cxy-299/jingjue-xingzhe/fpga/motor_bt_drive/README.md

# 蓝牙四向闭环离地试验（BTD5）

当前 SIN4 集成位流、IMU/ToF GUI 回传、ToF 急停锁停、逐轮 PI 故障定位与减速闭环的构建、仿真及 SRAM 下载记录见 [SIN4 维护记录](../../output/board/SIN4_PI_TOF_DIAGNOSTIC_2026-10-26.md)。[SIN3 维护记录](../../output/board/SIN3_TOF_STOP_INTERLOCK_2026-10-25.md)及下文保留早期阶段性结果，不能替代 SIN4 的实机验收。

本工程仅用于四轮**离地**验证蓝牙前、后、左、右控制，不能直接作为落地行驶或比赛正式位流。实物车头按用户确认的 **M1/M2 端**，M3/M4 为车尾。四路速度 PI 来自已经离地实测的 4CL2；BTD4 增加 S0 复位后的显式停止锁，BTD5 增加蓝牙侧编码器诊断回传。

## 硬件接线门槛

驱动板 12 V 先关闭，FPGA 和蓝牙模块断电后才接线。ZS-040 底板六针丝印（背面排针朝下从左到右）为 `EN、VCC、GND、TXD、RXD、STATE`；底板名称不代表某个确定的供电规格。先确认所持模块允许的 VCC 输入，再给模块单独上电并以模块 GND 为参考实测 TXD 空闲高电平；**确认不超过 3.3 V 后**，才能将 TXD 接 FPGA P7-23/E16。FPGA 与蓝牙模块须共地，5 V 绝不能直接送入 FPGA GPIO。

先下载 [蓝牙隔离回显位流](../bluetooth_bringup/README.md) 验收 9600/8N1、TXD/RXD 与回显；该位流所有电机输出固定为低。2026-10-24 已用 Windows 蓝牙 SPP COM9 发送 `A`、`B`、`A` 并收到完全对应的回显，证明电脑—蓝牙—FPGA 双向串口贯通，**未验证电机遥控**。当前 iPhone 小程序不支持这只经典蓝牙模块，可先使用 Windows。

## 手机蓝牙助手协议

Windows 可使用 [pc_bt_control.py](pc_bt_control.py) 进行离地遥控（`python pc_bt_control.py --port COM9`，需 `pyserial`）。点击连接发送停止 `S` 和标准速度档 `3`；还须手工勾选“允许离地试转”。方向按钮必须按住才会每 100 ms 重发，松开、窗口失焦或关闭时发 `S`。换向先停，必须松开后重新按目标方向。**BTD4 不要求按 FPGA S1**，但仍保留 S0 急停、FPGA 失联看门狗和驱动板电源开关。方向字节持续刷新时，点击锁定可以连续运行；最后一个刷新字节之后约 300 ms 无刷新，FPGA 自动停车。XCOM 不得同时占用 COM9；诊断仍走板载 COM6/115200。

手机按钮按下时每 100 ms 重发一个 ASCII 字符；松开时发一次 `S`。仅发送单个字节、不重复的按钮最多运行约 300 ms。`\r`、`\n` 和其他字符不刷新安全看门狗。

| 按钮 | 发字符 | 轮速方向（+ 表示该轮朝车前进方向） |
|---|---|---|
| 前 | `F` | M1+、M2+、M3+、M4+ |
| 后 | `B` | M1−、M2−、M3−、M4− |
| 左横移 | `L` | M1+、M2−、M3−、M4+ |
| 右横移 | `R` | M1−、M2+、M3+、M4− |
| 停止 | `S` | 全部 PWM、IN1、IN2 为低 |

`L/R` 使用标准麦克纳姆 X 布局组合；底盘滚轮的实际 X/O 安装、左右运动方向尚未落地验证。若实车安装不同，必须根据低速地面测试修正，不能凭离地轮转断言横移正确。

速度档位仅在停车时生效：`1`、`2`、`3` 分别设置闭环目标 **12、16、20 个编码器四倍频计数/10 ms**；运动中收到调速字节会忽略。电脑界面调档先发 `S` 再发档位字节。默认档位为 `3`；这些是计数目标，不是已校准的 m/s。最高档不超过此前四轮离地实测的 20，最低档能否稳定维持仍待实测。板载串口诊断中的 `Txxx` 随档位显示实际目标。

## GUI 死手控制与 FPGA 停机

1. 上电就绪后至少保持 100 ms 中性状态。GUI 的本地“允许离地试转”默认关闭；只有按住方向按钮才每 100 ms 重发 F/B/L/R，松开即发 `S`。FPGA 不依赖 S1。
2. 最后一个合法方向字节之后约 300 ms 无刷新即全停；同方向刷新会清零运行租约计时，不再因固定 3 秒计时器误停。换向仍须先发送 `S` 并等待约 100 ms 中性间隔，再发送新方向。
3. 从运动中直接换向立即停车并锁定；先发送 `S` 再发新方向。S0 急停直接门控全部输出；**S0 松开后仍锁停，持续刷新的旧方向字节无效，必须先收到 `S` 才能重新起动**。串口帧错误、任一编码器无反馈、反向反馈或超速也导致全停。若 GUI 已连接而 FPGA 后复位，先松开方向并点一次“停止 S”。
4. 四轮错峰起动由 BTD2 的每路 125 ms 缩为 **40 ms**（M4 最晚 120 ms），仍有 100 ms 起动脉冲。此前 0.5 秒 BTD2 试验中 M3/M4 几乎不转，最晚启动 375 ms 是重要解释，但尚不能排除机械阻力、供电或 PI 参数因素。PI 占空比限幅 300～850‰；只有离地验证后才能讨论落地调参。

板载 CH340 串口仍以 115200/8N1 轮询发送 `M1 T020 A+020 D0700 F0` 之类诊断帧；BTD5 还从 D16/P7-24 以 9600/8N1 向蓝牙模块回传同类 M1～M4 诊断帧，GUI 可在 COM9 显示最新行。LED2 心跳、LED3 就绪、LED4 任一路输出、LED5 蓝牙/连续运行超时、LED6 四路都曾收到反馈、LED7 安全告警。

## 离线验证与待测项目（2026-10-24）

### 2026-10-25 SIN1 点击锁定修正版

`bt_motion_guard` 对合法同方向刷新执行运行租约续期。统一驾驶台的点击锁定模式每 100 ms 刷新一次，持续刷新时不再触发旧的 3 秒误停；停止刷新约 300 ms 后仍由 FPGA 看门狗停车。新位流为 `output/board/SIN1_btd6_imu_tof_nav_follow_2026-10-25.fs`，User Code `0x53494E31`，SHA-256 `8EEC09957EC9EDD2FD184DC819683083E6EC29D3F582D849579DBED972C243C9`。该位流尚未完成本轮上板验证。

- ModelSim 2020.4 `vsim -c -do run_modelsim.do`：2026-10-24 BTD4 PASS，编译错误 0、警告 0；覆盖直接 GUI 控制 F/B/L/R、速度档、四轮反馈、停车后换向、300 ms 看门狗、S0 急停、串口帧错误和连续运行限时。测试使用缩短后的时序参数，真实硬件时间待实测。
- Gowin V1.9.12.04：GW5AT-LV60PG484AC1/I0，50 MHz 约束，BTD4 构建成功；实际 Fmax **73.696 MHz**，建立/保持违例端点 **0**；逻辑 4290/59904（8%）、寄存器 949/60780（2%），I/O 30/297。User Code `0x42544434`；位流 SHA-256 `CC67ECC88F99878250253F25BC49017DDE7BA7A33B6029F4A09D862D58EF7B04`。BTD3 位流在 `impl/pnr/acg720_motor_bt_drive_BTD3_backup.fs` 备份。
- BTD4 已在驱动板 12 V 关闭、四轮离地条件下下载到 FPGA **SRAM**，CLI 返回 `Finished`、User Code `0x42544434`、Status Code `0x70026020`；随后已用 Arora V 操作 54 完成外部 Flash 擦除/写入/校验，工具返回 `Program and Verify Flash successfully`，操作 66 独立复核返回 `Verify Flash successfully`。断电上电后的启动镜像仍需用户在安全状态下复核；未完成落地运动验证。
- 离地前进实测：无需 S1，GUI 按住 `F` 后四轮同向，松开后全停，LED7 灭。连续三组运行中诊断为 `A+024/+018/+016/+015`、`A+012/+016/+017/+018`、最终 `A+020/+020/+020/+021`，均为 `T020`；最终占空比 `D0702/D0716/D0710/D0713`，四轮稳态误差分别为 **0/0/0/+1 计数/10 ms**。这支持“离地稳态速度一致”的结论，但不能推断载荷下地面速度、位移或横移精度。
- 离地后退实测：GUI 按住 `B`，四轮最下缘均朝车头，松开后全停且无安全告警。运行帧 `M1～M4` 曾为 `A+013/+015/+016/+017`、`D0642/D0686/D0679/D0697`；稍后 M1～M3 均到 `A+020`，M4 同组 `D0000` 是松开时序附近的采样，不应解释为闭环驱动中占空比为零。后退轮向通过，四轮同时稳态收敛仍需更完整连续帧。
- 离地左横移轮向实测：`L` 时 M1/M4 最下缘朝车尾、M2/M3 朝车头，与 RTL 对角配对一致，松开全停、无告警。运行帧曾为 `A+028/+023/+022/+017`、`D0412/D0436/D0384/D0459`；下一组为 `A+011/+016/+014/+018`、`D0611/D0692/D0661/D0715`。仍属短时过渡采样，不能当成横移位移或稳态精度证明。

- 离地右横移轮向实测：`R` 时 M1/M4 最下缘朝车头、M2/M3 朝车尾，松开全停、无告警。连续三组 `T020` 下，四路 `A` 均为 `+020`；对应占空比约 `D0692～D0719`。这是轮速一致性与轮向验证，**不是落地横移位移验证**。
- BTD4 修复：复位及上电时 `require_stop=1`，防止 GUI 持续刷新 F/B/L/R 时 S0 松开即自行恢复运动。ModelSim 回归 PASS（编译错误/警告均 0），新增“复位后旧方向持续发送仍停机，收到 `S` 后才可重新启动”的检查。Gowin 50 MHz 时序下实际 Fmax **73.696 MHz**，建立/保持违例端点均 **0**；逻辑 4290/59904、寄存器 949/60780、I/O 30/297，User Code `0x42544434`，位流 SHA-256 `CC67ECC88F99878250253F25BC49017DDE7BA7A33B6029F4A09D862D58EF7B04`。驱动板 12 V 关闭时已下载到 SRAM，返回 `Finished`、Status `0x70026020`；上板 S0 锁停与 Flash 固化尚待验收。
- Windows GUI 优化版为 `pc_bt_control_btd4.py`：可扫描/选择 COM9、显示打开与发送故障状态、累计 TX 字节、最近发送时间及事件日志；写入超时或部分写入会立即断开并撤销试转许可。它明确标注“无 FPGA ACK”，因此不能把“COM 已打开”误当作 FPGA 已收到。

## 分阶段实测记录

## BTD5 固化记录（2026-10-24）

- BTD5 位流增加独立蓝牙 TX 诊断通道，用户码 `0x42544435`；ModelSim 回归通过，Gowin 实际 Fmax 63.187 MHz，建立/保持违例端点均为 0，位流 SHA-256 为 `E292132B9363492BCEEF198E7BA65C3929F3D40B9E18930D43A1070A3C8DF210`。
- BTD5 已在四轮离地、驱动板 12 V 关闭条件下下载 SRAM，随后通过 Gowin Programmer 操作 54 写入外部 Flash；操作 66 独立校验返回 `Verify Flash successfully.`。用户码、Flash ID `0xC22018` 和校验日志保存在 `impl/pnr/btd5_flash_verify_20261024.log`。
- 维护复现步骤、完整命令、接线、电气门槛、GUI 操作、回滚和未完成实测项目见同目录 [BTD5维护与复现手册.md](BTD5维护与复现手册.md)。

| 阶段 | 通过条件 | 当前状态 |
|---|---|---|
| 模块电气 | VCC 规格确认、TXD 空闲高电平 ≤3.3 V、共地 | 待测 |
| 隔离回显 | 12 V 关闭，Windows COM9 发送 `A/B/A` 并收到对应回显，电机输出恒低 | 已通过（2026-10-24） |
| 离地遥控前进 | `F` 同向、松开停、T020 下四路速度收敛、LED7 灭 | 已通过初步实测（2026-10-24） |
| 离地遥控后退 | `B` 四轮最下缘朝车头、松开停、无告警 | 已通过初步实测（2026-10-24） |
| 离地左横移轮向 | `L` 对角轮向组合、松开停、无告警 | 已通过初步实测（2026-10-24） |
| 右横移轮向 | `R` 对角轮向组合、松开停、T020 四轮收敛 | 已通过离地初步实测（2026-10-24） |
| 安全保护 | BTD4 S0 锁停、断连、3 秒限时的实物效果 | S0/取消试转后输出熄灭已观察；LED7 告警原因需继续记录；ModelSim 已通过 |
| 低速落地 | 另行制定低速限时位流与现场安全边界 | 禁止直接开展 |
