cxy-299/jingjue-xingzhe/fpga/motor_encoder_direction/README.md

# M1 电机—编码器方向联调（EMD1）

本工程用于确定 M1 在既定 `IN1=1、IN2=0` 驱动方向下，编码器四倍频计数的符号。它是**单轮开环限时诊断位流，不是 PID 闭环**；其余 M2～M4 的 PWM、IN1、IN2 输出均保持低。M1 对应车上的 B 轮（左后），编码器 AM1/BM1 必须先经 TXS0108E 由 5 V 转为 3.3 V，接到 FPGA P7-15/16（D14/D15），禁止直连 5 V。

## 电机输出与指示

- S0：立即停止并清除编码器结果；S1：单击启动、再单击停止。一次启动最长 700 ms，到时自动停机。
- M1 启动时先 100 ms 全占空比起动，随后 80% 占空比，载波目标 20 kHz；M1 的 IN2 始终为低。
- LED2：心跳；LED3：启动互锁完成；LED4：M1 正在运行；LED5：本次运行达到 700 ms 自动超时；LED6：本次**电机主动驱动期间**至少收到一次 M1 编码器计数变化；LED7：最后一次计数变化为负数。LED6/7 只在下一次启动或 S0 复位时清除。
- LED6 未亮时，不能依据 LED7 判断方向；LED7 只反映最后一次脉冲的方向，不能代表全程没有反向毛刺。

## 安全上板顺序

1. 四轮离地，驱动板 12 V 关闭，S1 松开。确认 FPGA 与驱动板共地、TXS0108E A/B 两侧供电及 OE 使能正确。
2. 仅以 Gowin Programmer 的 **SRAM Program** 下载 `impl/pnr/acg720_motor_encoder_direction.fs`，确认 `Finished`、User Code `0x454D4431`（EMD1）。不得写入 Flash。
3. 保持 12 V 关闭，确认 LED2 闪烁、LED3 常亮、LED4～7 全灭。若不符，不要开启 12 V。
4. 开启 12 V 后先观察是否有意外转动、发热或异味。确认安全后单击 S1 一次，观察是否只有 M1 转动、实际车轮下缘运动方向，以及运行结束后 LED5/6/7 状态；任何异常立即关闭 12 V 或按 S0。
5. 记录电机驱动方向与编码器符号后，关闭 12 V。本工程不能验证 PID 调参、四轮速度一致性、导航或带载表现。

## 离线与下载记录

- ModelSim：`PASS tb_acg720_motor_encoder_direction: one motor, quadrature sign, timeout, reset`，0 errors、0 warnings。
- Gowin V1.9.12.04：50 MHz 约束，Actual Fmax 88.574 MHz，建立/保持违例终点均为 0。
- SHA-256：`EC23F8245BFC12994D72D247DF6162993F515B62441F45B4769636723D2BDF4C`。
- 2026-10-23：在用户确认驱动板 12 V 关闭、四轮离地后，仅下载到 FPGA SRAM。Gowin CLI 回报 `Finished`、User Code `0x454D4431`、Status Code `0x70026020`。

## 2026-10-23 M1 上板结果

- 用户确认 12 V 关闭时 LED2 闪烁、LED3 常亮、LED4～7 全灭。开启 12 V 而未按 S1 时，四轮静止，无异味、明显发热或电源异常。
- 单击 S1 后只有 M1（B 轮、左后）转动，其轮子下缘朝车尾运动，约 700 ms 后自行停止。停后 LED5、LED6、LED7 全亮。
- 由 LED5 确认硬超时动作；LED6 确认主动驱动期间 M1 编码器确有计数；LED7 说明最后一次计数变化为负。这与先前按车辆前进方向手转 M1 观测到负计数一致。
- 用户随后确认关闭驱动板 12 V。当前只确认 M1 的**方向极性及低速反馈存在**；尚无每 10 ms 的实测计数、编码器每圈计数或速度环调参数据，不能宣称闭环已通过。
