cxy-299/jingjue-xingzhe/fpga/COMPETITION_INTEGRATION_2026_CN.md

# 赛题三最终整合与高分验收路线（2026-10-24）

目标板：ACG720 / GW5AT-60B。场地草案：2 m × 2 m、20 × 20 格；车头为 M1/M2 端。IMU 实物明天到，今天不假定型号、协议或角度方向。本文是实施与验收计划，**不是整车已经通过的声明**。

比赛依据：[高云 2026 官方选题三](https://www.gowinsemi.com.cn/university/match2026)。官网明确列出基础任务 1～4 和扩展任务 5～6；作品提交时间写为 **2026-11-04 18:00**，决赛为 11 月 20～22 日。用户截图中的 40%/25%/20%/10%/5% 分布作为备赛优先级参考，官网当前网页未给出同一评分权重，不能把它写成官方量化规则。基础任务采用 FPGA/板上软核独立完成的设计路径；树莓派负责扩展视觉、交互、日志，不替代 FPGA 安全控制与导航执行。树莓派 4B 是否满足扩展平台细则，以比赛补充规则或组委会答复为准。

## 1. 当前真实性能基线

| 任务 | 已有可复核证据 | 整合版仍缺 |
|---|---|---|
| T1 摄像头 + IMU + 同屏显示 | OV5640 厂家 HDMI 独立 SRAM 位流，用户现场确认实时画面正常；IMU UART 解析仿真 | IMU 实物协议/角度验证，HDMI 姿态角 OSD，同一位流运行 |
| T2 前后/转向/定点旋转 + 编码器闭环 | BTD5 四轮离地 F/B/L/R 闭环、松手停；写入 Flash 并校验 | `L/R` 当前是横移，**不是定点旋转**；转弯/原地旋转指令与载地实测仍缺 |
| T3 测距/减速/停车/自主绕障 | 一只 MS53L2M 原始距离 455～467 mm、分档 LED 现场通过 | 安全链未接电机；没有实物减速/制动/绕障；仅一只前向 ToF 不能提供四周覆盖 |
| T4 起终点/避障/路径点导航 | BTD6 完整路径帧、CRC、编码器逐格执行已仿真并离地验证；GUI 地图 v4-balanced 保留原版四个障碍位置并各缩短约 2 格；1/2/3/34 步目标均完成；转向路点之间加入中性停车 | 当前仍以固定起点和 GUI 路径为主；ToF 动态障碍已完成软件安全/重规划仿真，尚未接入 BTD6 顶层和实车回执 |
| T5/T6 扩展 | Pi 侧瓶子识别与网页画面曾实测 | 红瓶筛选抗干扰、目标定位、搜索→接近→停止全任务未实车验证 |

**结论：单模块测试已为整合降低风险，但 T1～T4 尚不能宣称整题完成。**既有 BTD5 Flash 是回退基线，不在整合版本通过全套验证前覆盖。

## 2. 最终单一系统的数据和控制边界

```text
OV5640 ─ SCCB/DVP ─ DDR3 ─ 显示时序 ─ 字模OSD ─ HDMI
IMU ─ 校验/角度/时效 ───────┘       └─ 航向估计
ToF(前，未来多方向) ─ 距离/时效 ─ 安全与局部障碍层 ─┐
编码器 M1～M4 ─ 速度/里程计 ─ 位姿估计 ─ 路点跟踪 ─┼─ 唯一运动仲裁 ─ 四路 PI/PWM ─ 驱动板
已知地图 + 当前位姿 + GUI 目标 ─ FPGA BFS/重规划 ─┘
蓝牙手动/树莓派视觉目标 ─ 模式请求与低带宽遥测（不得直接写 PWM）
``` 

- **唯一电机所有者：FPGA。** 蓝牙、GUI、导航、红瓶任务只能提交有时效的运动意图；控制仲裁每周期只选一个来源。S0 急停 > ToF 近距或必需传感器失联 > 编码器/驱动故障 > 通信超时 > 当前模式命令。故障后要求中位命令和人工重新使能，不允许旧命令自动续跑。
- **执行器基线沿用 BTD5。** 它是当前真实驱动板上离地验收过的四路 PI/PWM 和编码器符号；旧版 `fpga_robot_core.v` 或 NAV3 预览顶层不能未经硬件重验就替换该执行器。先把 BTD5 的命令来源抽象为模式仲裁输入，再接导航和 ToF，不同时维护两套轮序/电机极性。
- **单一时间/坐标定义：** 地图原点左下、`x` 向右、`y` 向上；车体前向为 M1/M2 一端。IMU 的 yaw 零点、正方向需实物标定。地图坐标与车体前/右速度经过航向变换后才送麦轮混控。地图版本、GUI 预览、FPGA ROM 和实体障碍布局必须同源生成。
- **角度显示：** 在 HDMI 像素输出至编码器之前叠加 roll/pitch/yaw、距离、模式和故障字样；多位姿态数据跨时钟域握手后在帧边界更新，超时显示 `IMU LOST`。Pi 网页可镜像遥测，但不能是基础任务唯一显示。
- **蓝牙与 ToF 管脚：** ToF 诊断曾临时复用蓝牙 RX 所在 E16/P7-23；整合版须逐根重新分配，不能让两个 TXD 并接。合并相机/HDMI/DDR3/电机/编码器/IMU/ToF 约束后再跑 IO 冲突与时序检查。
- **安全距离：** 现有 800/500/250 mm 仅是代码初值，不是地面安全证明。需实测最坏控制/测距延迟和最大减速度，按 `停止距离 ≥ 速度×延迟 + 速度²/(2×减速度) + 车体余量` 设动态阈值；失联时前进停车。

## 3. 优先级与交付门槛

### A. 先保证基础任务可得分，再做扩展

1. **T2 补全动作。** 在 BTD5 的四路速度闭环之上添加转弯和原地左/右旋转，不把横移充当旋转。先仿真四轮符号、停车换向和编码器失效，再离地、最后空旷地低速落地测角度/直线误差。
2. **T3 接入安全链。** 单只前向 ToF 可先完成“前进发现→自动减速→自动停”实车证据；自主绕障须在停稳、已知车体扫掠空间安全、局部占据更新后重新规划。单只前向传感器无法给侧移和盲区旋转提供全周安全保证；若要现场稳定演示绕障，优先补多方向 ToF，而不是提高 PWM。任何无路、未知空间或传感器失效都停车。
3. **T1 合成 HDMI+IMU。** IMU 到货后先核对真实波特率/帧格式/电平与方向，再叠加姿态角；独立摄像头画面和传感器数值要在同一位流、同一显示器上同时工作。
4. **T4 实际导航闭环。** 从当前实测位姿而非固定 `(18,1)` 起算；`BFS 路点→低速跟踪→编码器+IMU位姿→到点脉冲 advance_i→下一路点`。ToF 发现新障碍时停稳、更新局部占据、从当前位姿重规划；到终点需位置/航向/低速持续满足再回报 `ARRIVED`，不能仅凭浏览器蓝线或 FPGA `ready` 灯。
5. **T5/T6 最后扩展。** FPGA 基础任务已稳定后，Pi 做红瓶检测，发目标类别/置信度/方位及时间戳；FPGA 负责搜索、对准、接近和安全终止。勿让红瓶推理卡顿维持陈旧运动命令。

### B. 设计门禁（每一版都要过）

| 门禁 | 通过标准 | 证据 |
|---|---|---|
| 静态 | 无重复 IO、无电压超限、时钟/复位/跨时钟域审查通过 | 管脚矩阵、约束差异、CDC 清单 |
| 仿真 | 正常、边界、失联、错误帧、复位、故障抢占均有断言 | ModelSim 日志与原始波形 |
| 实现 | Gowin 综合/PnR 成功，建立/保持违例为 0，资源有余量 | `.rpt.txt`、User Code、位流 SHA-256 |
| 无动力上板 | 12 V 关闭，视频/IMU/ToF/蓝牙/导航回执同版通过 | 现场录像、遥测日志 |
| 离地动力 | 四轮方向与闭环正确，近障/失联立即禁止 PWM，松手停 | 连续测速与故障注入记录 |
| 落地 | 空旷场低速开始；重复试验不碰撞，测制动、到点和回退 | 卷尺/轨迹/视频/试验表 |

评委演示时应能在 HDMI 上看到摄像头、姿态、距离、当前模式与停机原因；在 GUI 上看到地图、**FPGA 回执**、当前估计位姿、规划/执行/到达状态及四轮目标/实测速度。网页“发送成功”只表示 Pi 写串口，绝不能显示为“FPGA 已到达”。

统一电脑驾驶台的现有安全首版与最终 COM9 协议门槛，见 `motor_bt_drive/统一驾驶台_维护与整合说明.md`。当前仅同窗提供 BTD5 离地遥控、编码器回传、地图预览；NAV/任务按钮在新 FPGA 位流与 ACK 完成前锁定。

## 4. 地图与机械几何必须先校正

当前 GUI 地图 v4-balanced 是 10 cm/格、原版四个障碍位置的缩短版；A 为 `(11,4)` 的 2×3 格，B 为 `(6,9)` 的 2×2 格，C 为 `(13,13)` 的 2×2 格，D 为 `(4,15)` 的 1×2 格。车辆约 20 cm 宽，却采用 15 cm 膨胀半径，起点中心仅距边界 15 cm。若含麦轮、线材的实际长宽约 20×20 cm，原地旋转包络半径约 14.1 cm，加 5 cm 裕量约 19.1 cm；现起点与膨胀设置不能直接保证安全。落地前量出车体最大外廓、轮距和转弯扫掠，将地图、PDF、网页、FPGA ROM 同时升级版本；**不静默沿用地图 ID `0x2601`**。四轮目标 `T020` 是编码器计数/10 ms，不是 m/s；要实测轮径、每转计数、地面滑移才可换算位移。

## 5. 提交前的时间优先级与回退

按官网 11 月 4 日 18:00 提交节点，先冻结一版可复现实演的基础系统，再加风险较高的任务。建议顺序：

| 阶段 | 主要交付 | 失败时保底 |
|---|---|---|
| IMU 到货当天 | 原始帧/方向验证，HDMI 姿态 OSD 仿真与 SRAM 同屏 | 保留独立 HDMI 画面和可复核 IMU 原始采集，不伪称同屏 |
| 随后 | T2 原地旋转、T3 单向减速停车，离地→落地低速验收 | BTD5 Flash 可随时恢复四轮遥控基线 |
| 基础稳定后 | 位姿估计、当前起点 BFS、路点跟踪、目标回执，2×2 m 多目标重复跑 | 展示 FPGA 路径规划和部分路点闭环，明确未完成的整车能力 |
| 最后 | 动态绕障、红瓶识别/搜索接近、答辩视频与证据包 | 绝不牺牲基础稳定性换未经验证的 AI 展示 |

内部建议验收量化（**非官方门槛**）：每个运动/避障/导航场景至少 5 次重复；0 次碰撞；保存每次起终点误差、最大姿态误差、最近障碍距离、故障状态和完整版本号；让失联/急停/重启测试可由评委现场复现。最终报告逐项区分“仿真通过”“离地通过”“落地通过”“未通过”，不以演示视频替代原始数据。

## 6. 评委可直接看见、又确有技术内容的亮点

1. **一屏可解释的 FPGA 实时链路：** HDMI 同时显示现场摄像头、姿态角、前方距离、四轮闭环状态、导航模式和停车原因；断开 Pi 后基础功能继续运行，以实物展示 FPGA 主控职责。
2. **可量化的确定性安全：** 用逻辑分析/串口时间戳与录像测量“测距帧到达→降速/禁 PWM”的最坏时延，再结合地面制动实验给出速度相关安全距离；使用预先设计的断线测试开关或在断电状态下配置故障场景，验证失联停车，不带电拔插传感器。
3. **真正闭环而非动画：** 让网页的规划路线、FPGA 回传的路点编号、编码器/IMU 位姿和实车轨迹同时可见；故意放置未在固定图中的障碍，展示停稳、重规划与继续执行。若当时未实现，不在报告中写成已完成。
4. **严格可复现：** 每次演示保存地图 ID、位流 SHA-256/User Code、管脚表、ModelSim 日志、时序余量、原始串口数据、至少 5 次重复试验统计以及失败案例。创新点必须附可观测证据，不只写算法名。
