cxy-299/jingjue-xingzhe/fpga/CONTROL_AUDIT_2026-10-14_CN.md

# FPGA 控制逻辑核查与赛题三差距（2026-10-14）

本次只做源码检查与软件仿真；没有重启电脑、连接电机、下载 FPGA 或改变板卡固件。

## 仿真证据与边界

在独立目录 `verify_motion_20261014` 中，ModelSim SE-64 2020.4 的 `vlog` 已将 10 个 RTL 和 4 个 testbench 编译为 **0 errors / 0 warnings**。本次终端启动 `vsim -c` 返回 `Invalid license environment`；尝试打开已安装的 ModelSim GUI 也没有产生可操作窗口。因此不能声称本次 ModelSim 仿真通过；用户先前在 GUI 手动执行的三项 PASS 日志与本次 XSIM 结果相符。许可证/GUI 恢复后，可按 `MOTION_MODELSIM_MANUAL_CN.md` 重新在 GUI 跑四项。

同一源码用 Vivado XSIM 2019.2 独立完成：

| 自检顶层 | 结果 | 覆盖要点 |
| --- | --- | --- |
| `tb_motion_policy` | PASS，230 ns | 安全优先级、无目标搜索、确认、跟随、死区 |
| `tb_wheel_control` | PASS，2531 ns | 麦轮混控、编码器正反计数、PI 禁用、PWM |
| `tb_four_wheel_pid` | PASS，1151 ns | 四路独立占空比、D 项、防积分饱和、停车 |
| `tb_drive_rearm_guard` | PASS，111 ns | 立即关断、等待控制周期恢复、短故障脉冲锁存 |

以上证明已覆盖的**逻辑片段**自洽，不证明完整系统已经可在 ACG720 上跑。特别是四路 PWM 自检使用仿真缩短的载波周期，并没有验证真实 20 kHz 输出的管脚波形、电平、电流或方向极性。

## 本次逻辑优化

之前急停或 ToF 故障解除时，旧的占空比有机会在下一个控制时钟清空前短暂重新出现。增加 `drive_rearm_guard.v` 后，任何故障立即组合关断 `motor_enable/PWM`，同时异步锁存；故障解除后必须等下一控制周期才放行。测试还覆盖短于时钟周期的故障脉冲。板级仍需确认驱动器的使能极性、硬件急停与故障输入是否真正连入。

## 对照赛题三的完成状态

根据 `E:\gowin\高云.pdf` 第 17–18 页，基础任务包括相机采集/显示和 IMU 姿态显示、编码器闭环运动、传感器避障并自动绕行、起终点及途经点自主导航；扩展任务才是视觉目标搜索与语义任务。当前状态：

| 要求 | 当前代码 | 结论 |
| --- | --- | --- |
| FPGA 实时运动控制、四轮编码器速度闭环 | 麦轮、四路编码器、PI/PID、PWM 已有独立仿真 | 逻辑雏形已具备；板级未集成/标定 |
| 树莓派视觉信息到 FPGA | UART 解析、CRC、心跳及超时已有测试 | 通信逻辑具备；完整系统联调待做 |
| 摄像头采集/图像及 IMU 姿态实时显示 | 目前无 FPGA 相机采集/显示和 IMU 模块 | 未完成 |
| ToF/超声/雷达减速、停车、绕障 | 单一前向 ToF 距离策略仅会减速/停车/视觉跟随 | 绕障未完成；传感器适配器未完成 |
| 起点到终点、途经点自主导航 | 无定位融合、地图/路径/途经点模块 | 未完成 |
| 红水瓶识别/定位/搜索 | 视觉包有目标字段，策略可原地搜索/对位/接近 | 红瓶识别、坐标定位和目标任务闭环未完成 |

因此当前方案**符合“FPGA 应承担运动控制核心”的方向，但尚不满足赛题三整题交付**。现有 `vision_motion_controller.v` 是目标跟随策略，不应命名或展示为完整自主导航。树莓派可做 YOLO 感知，但不应把路径、避障和轮控决策全部放在树莓派上。

## 上板前的硬性条件

1. 明确 ACG720 时钟、电平、UART、四路编码器、PWM/方向/使能及驱动故障引脚，制作板级顶层和约束；核对新驱动板实际接口。
2. 标定实际电机编码器方向、每控制周期的计数范围、轮序和机械方向。`WHEEL_COUNTS_AT_FULL_SCALE` 当前默认 0，故意锁住电机输出。
3. 完成至少前向 ToF 的真实数据接收、超时和无效值处理；绕障需多方向测距或可观测的替代传感信息。
4. 增加完整核心集成 testbench：真实 UART 帧进入、ToF 状态变化、四轮参考/测速/PWM、失联/急停/复位均须断言。之后再做离地低速联调。
5. 导航另建 FPGA 侧位姿/路标、地图或航点、路径状态机和避障状态机；IMU 数据采集及显示依赛题要求补齐。

蓝牙功能只做预留设计，详见 `BLUETOOTH_CONTROL_PLAN_CN.md`。当前 `wheel_pi.v` 增益是综合时常量，**手机不能在线调 PID**；不能将待开发功能算作已验证。
