cxy-299/jingjue-xingzhe/fpga/motor_bt_drive/BTD6导航下发与复现手册.md

# BTD6 FPGA 自主导航下发与复现手册

## 1. 目标与边界

BTD5 是已经完成实测的蓝牙四轮闭环手动固件；BTD6 在其基础上增加一条
“完整路径帧 → FPGA CRC/地图校验 → 编码器路点执行”的链路。电脑或树莓派负责
在同一张 20×20 地图上规划路径并发送方向序列，FPGA 只接受经过 CRC、地图 ID、
长度和方向码校验的完整路径，不接收 PWM 或轮速命令；四轮 PI、ToF 急停和 S0
安全停机仍由 FPGA 负责。

BTD5 与 BTD6 使用同一个蓝牙 9600/8N1 物理链路，但 BTD5 的导航入口保持关闭。
统一驾驶台默认选择 BTD5，只有选择 BTD6、核对位流并勾选“允许自主导航”后，
“发送终点到 FPGA”按钮才会开放。

## 2. 导航帧

沿用工程已有的协议 v3：

BTD6 使用路径消息 `type=21`。payload 为地图 ID、终点坐标、步数和每步方向：

```text
AA 55 | version=03 | type=21 | seq(u16 LE) | len=(5+n) |
map_id=2601(u16 LE) | goal_x | goal_y | n | dir[0..n-1] |
crc16-ccitt(u16 LE)
```

例如终点 `(2,17)`、序号 1 的 14 字节帧为：

```text
AA 55 03 21 01 00 07 00 01 26 02 11 02 02 00 84 C2
```

方向码固定为 `0=F、1=B、2=L、3=R`。FPGA 只有在 CRC、版本、消息类型、长度、
地图 ID、坐标范围和方向码全部正确时才替换当前路线；坏帧不会改变当前路线。
当前 GUI 地图为 v4-balanced（原版四个障碍位置的缩短版）。FPGA 接收的是完整路径，不保存 GUI
静态障碍表，因此修改地图后不需要改变执行器逻辑，但必须重新确认地图膨胀与实体
场地一致。

## 3. FPGA 执行逻辑

`acg720_motor_bt_nav` 使用 `NAV_ENABLE=1` 打开导航入口：

1. `uart_rx` 以 9600 baud 接收蓝牙字节。
2. `nav_path_parser` 验证 v3/CRC、地图 ID、长度和方向码并产生一个路径脉冲。
3. `nav_route_executor` 按收到的 F/B/L/R 序列逐格执行，并以四路编码器位置的
   平均绝对增量达到 `NAV_CELL_COUNTS` 判断走完一个 10 cm 单元格。
4. 每次只消费一个方向码；方向改变时先插入约 100 ms 中性停车，再开始下一格；抵达终点后自动输出 STOP。
5. 手动命令与导航互斥；S0、编码器故障、蓝牙看门狗和导航异常均优先停车。

`NAV_CELL_COUNTS` 是必须通过实车标定的参数，当前暂设 1000。落地前应在直线
标定段测量 10 cm 的平均编码器增量，再重新综合；不能直接把仿真值当成实际距离。

## 4. 动态障碍处理边界

当前 BTD6 已具备固定路径的编码器执行，但尚未把 ToF 输入接入该顶层。正式动态
绕障流程必须是：

1. ToF 连续有效时按距离阈值分级减速；进入硬停止距离立即禁止 PWM。
2. 停稳后锁存当前执行格和剩余路径，不能继续盲走。
3. 将 ToF 命中的前方格按车体外廓膨胀写入局部占据图。
4. 由 GUI/Pi 或 FPGA 重新规划“当前格→终点”的完整路径，再经 `type=21` 帧发送。
5. 只有收到合法新路径并重新使能后才继续运行；ToF 无效、无路或侧向不可观测时保持停车。

单个前向 ToF 只能可靠完成前方减速/停车，不能独立证明侧向绕障安全。要做可复现
的自动绕障，应增加左右/后向测距，或在停稳后由摄像头/人工确认局部地图，再重新规划。

## 5. 仿真

在 `fpga/motor_bt_drive` 目录执行：

```text
vlog -work sim_btd6_nav_check ..\nav\nav_path_parser.v ..\nav\nav_route_executor.v acg720_motor_bt_drive.v acg720_motor_bt_nav.v tb_acg720_motor_bt_nav.sv
vsim -c -voptargs=+acc sim_btd6_nav_check.tb_acg720_motor_bt_nav -do "run -all; quit -f"
```

必须看到：

```text
PASS tb_acg720_motor_bt_nav: Bluetooth route -> FPGA encoder waypoint
```

该回归覆盖合法路径帧、CRC/地图校验、方向序列加载、首个方向和编码器增量消费；
不代表落地实车已完成，需要另做离地和低速落地验收。

## 6. 综合与下板

先运行 `build_btd6_nav.tcl` 生成 BTD6 位流，用户码为 `0x42544436`。第一次只
使用 SRAM Program，不写 Flash：四轮离地、驱动板 12 V 关闭、JTAG 接好后再下载。
上电初态应为 LED2 心跳、LED3 就绪、LED4～LED7 熄灭。确认编码器回传后再打开
12 V；第一次只做离地单格导航，第二次才做 10 cm 低速落地测试。

标定与正式落地顺序：

1. GUI 选 BTD6、核对地图和障碍膨胀，勾选“允许自主导航”。
2. 选择距离起点 1 格的可达终点，发送后观察四轮是否同向、是否在一个格后停稳。
3. 用尺测量实际位移，按 `NAV_CELL_COUNTS = 编码器增量/0.1 m` 更新参数。
4. 逐步测试 2 格、转角、障碍绕行和 ToF 自动减速/停车。
5. 任意异常先点“停止导航 S”，再关闭驱动板 12 V；不要边带电边改线或切换位流。

## 7. 当前未宣称项目

BTD6 首版仍假设车辆从固定起点 `(18,1)` 开始，尚未接入 IMU 姿态融合、ToF
动态重规划、摄像头目标任务和 FPGA→GUI 的二进制 ACK。GUI 的“已写入”只表示
Windows 串口写入成功；只有后续收到 FPGA 状态帧或完成实车验收，才能在比赛报告
中写成“任务完成”。
