cxy-299/jingjue-xingzhe/THIRD_PARTY_NOTICES.md

# 第三方组件与资料

本工程保留源文件原有的版权、作者和许可标识。仓库未为全部文件统一授予新的开源许可证。

- 高云器件原语、PLL及相机/HDMI参考代码沿用原厂或开发板资料中的授权条件。Gowin与Questa/ModelSim安装程序、完整厂商仿真库不在仓库内。
- 可选YOLO后端依赖Ultralytics及其模型。使用、修改或分发相关代码与权重时，应遵守其原始许可证及模型使用条件。当前数字靶标识别默认使用项目的模板识别通路。
- Python、NumPy、OpenCV、PyYAML、pyserial、Picamera2、pytest以及微信开发者工具分别遵循其自身许可证或服务条款。
- `data/`为工程原有实验图像、标注与数据记录，保留原有用途与来源；硬件设计文件与图片作为本项目的配套资料保存。

依赖通过各自的官方发行方式安装，仓库中的说明不替代第三方许可文本。
