cxy-299/jingjue-xingzhe/data/field_bottle/raw/20261030T112852182968Z/00021.jpg

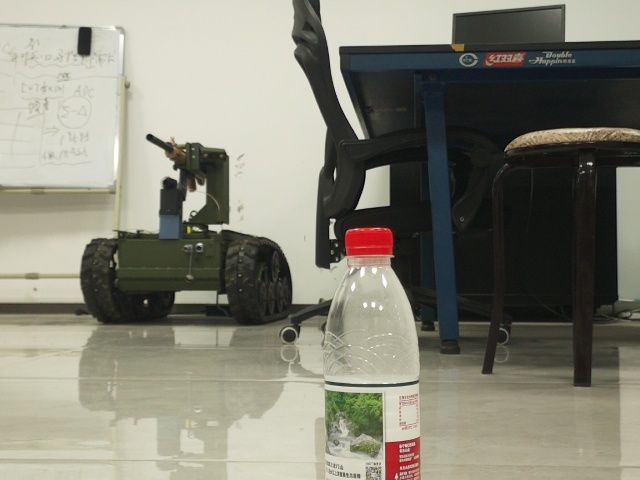
data/field_bottle/raw/20261030T112852182968Z/00021.jpg
