cxy-299/jingjue-xingzhe/data/field_bottle/raw/20261030T114926963797Z/00014.jpg

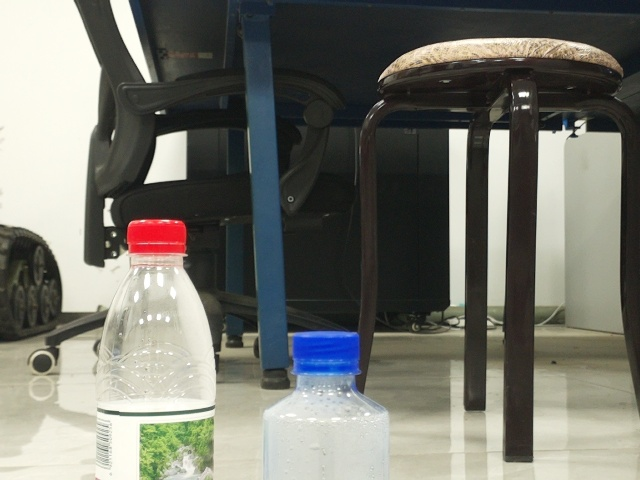
data/field_bottle/raw/20261030T114926963797Z/00014.jpg
