cxy-299/jingjue-xingzhe/data/field_bottle/raw/20261030T121004313350Z/00028.jpg

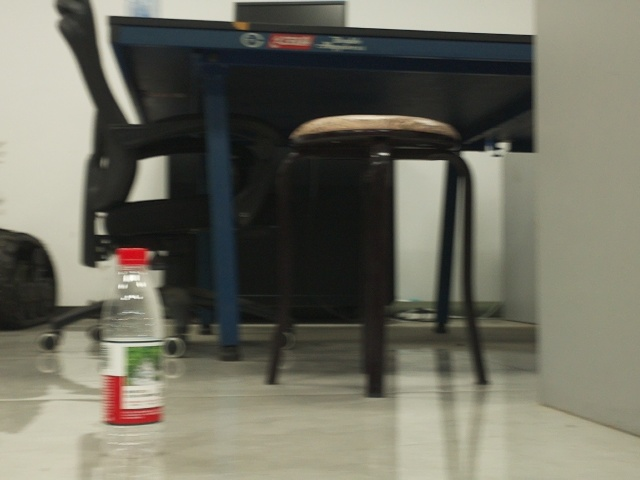
data/field_bottle/raw/20261030T121004313350Z/00028.jpg
