cxy-299/jingjue-xingzhe/data/field_bottle/raw/20261030T121153141556Z/00029.jpg

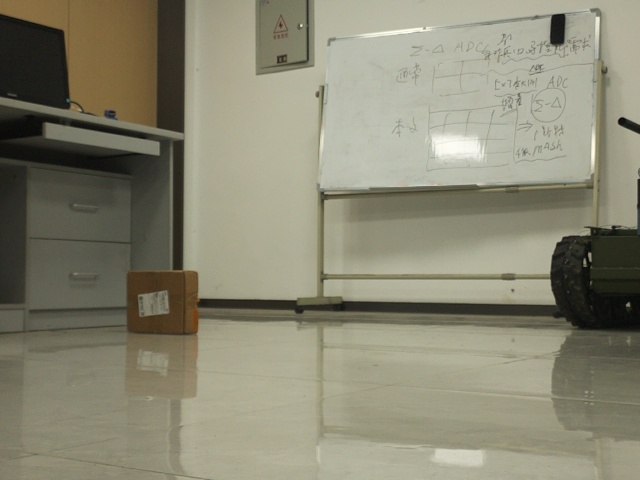
data/field_bottle/raw/20261030T121153141556Z/00029.jpg
