cxy-299/jingjue-xingzhe/data/field_bottle/raw/20261030T122827797892Z/00018.jpg

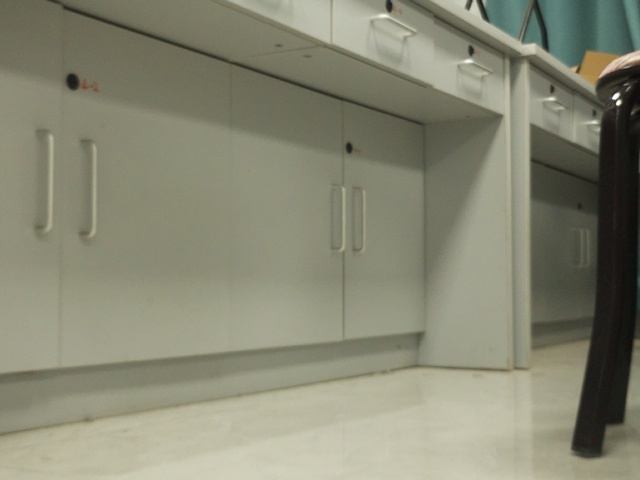
data/field_bottle/raw/20261030T122827797892Z/00018.jpg
