cxy-299/jingjue-xingzhe/data/field_bottle/raw/20261030T123711025227Z/00011.jpg

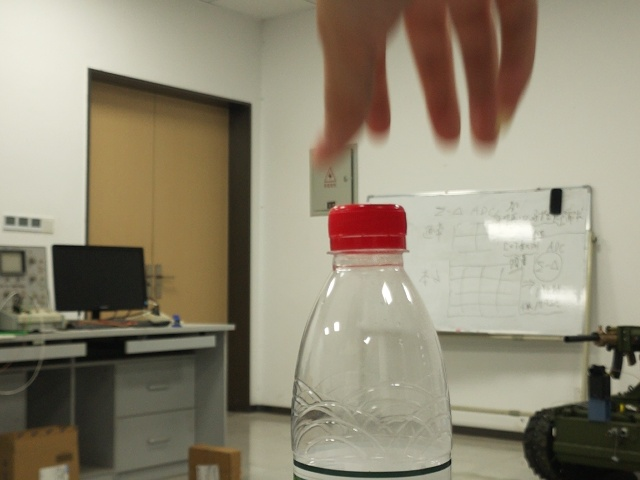
data/field_bottle/raw/20261030T123711025227Z/00011.jpg
