cxy-299/jingjue-xingzhe/data/field_bottle/raw/20261030T123711025227Z/00013.jpg

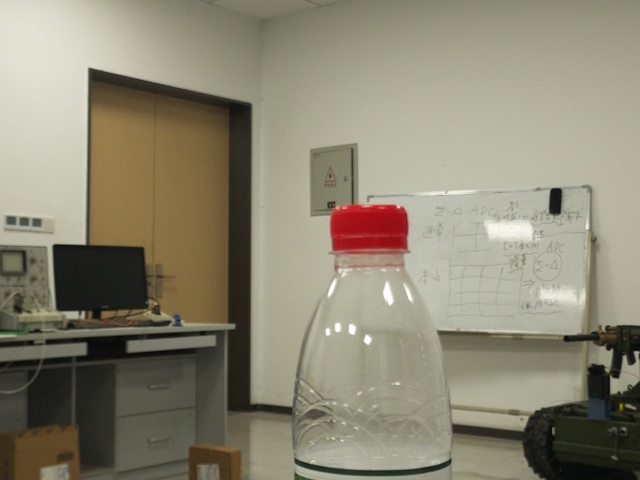
data/field_bottle/raw/20261030T123711025227Z/00013.jpg
