cxy-299/jingjue-xingzhe/data/field_bottle/raw/20261030T124541207972Z/00016.jpg

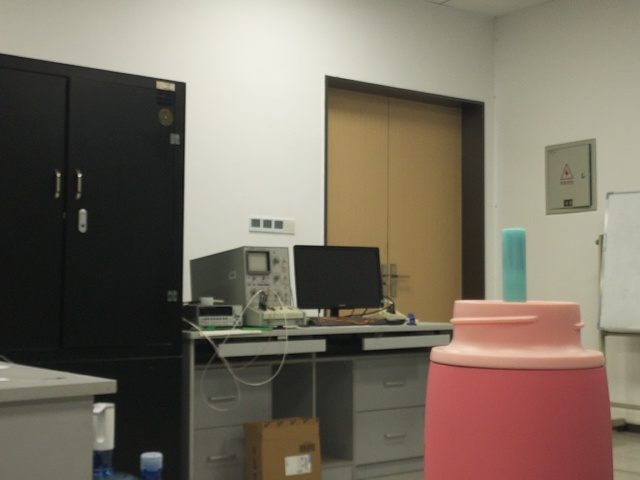
data/field_bottle/raw/20261030T124541207972Z/00016.jpg
