cxy-299/jingjue-xingzhe/data/field_bottle/raw/20261030T124910374626Z/00000.jpg

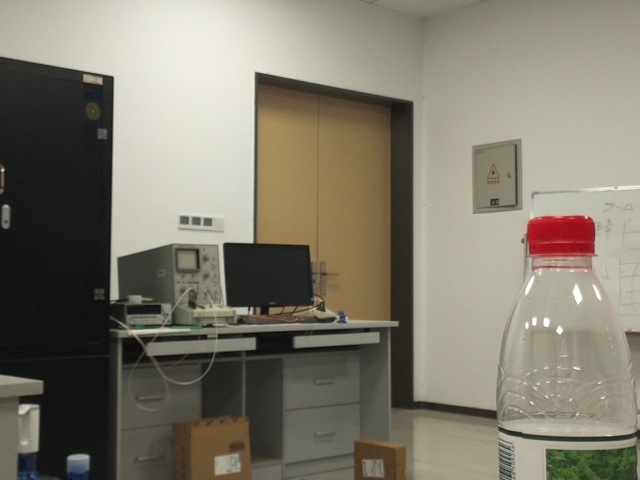
data/field_bottle/raw/20261030T124910374626Z/00000.jpg
