cxy-299/jingjue-xingzhe/data/field_bottle/raw/20261030T125230938720Z/00015.jpg

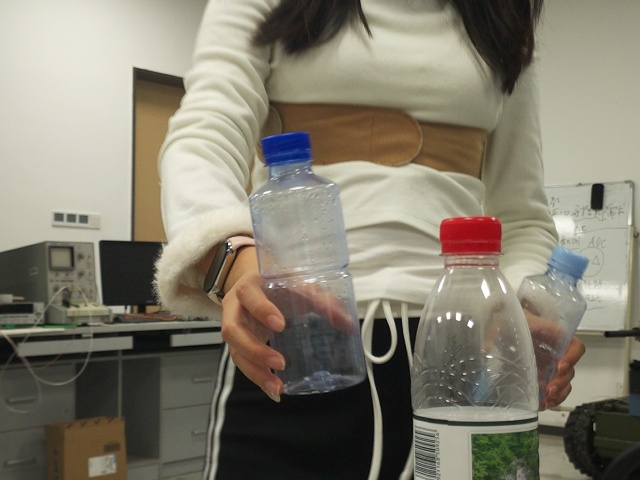
data/field_bottle/raw/20261030T125230938720Z/00015.jpg
