cxy-299/jingjue-xingzhe/data/field_bottle/raw/20261030T130046322943Z/00007.jpg

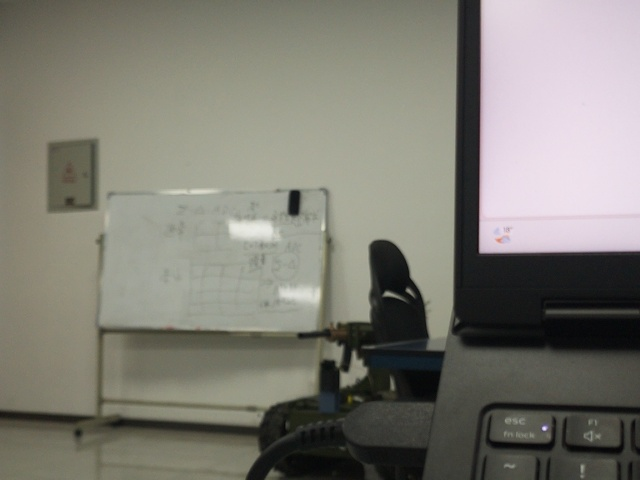
data/field_bottle/raw/20261030T130046322943Z/00007.jpg
