cxy-299/jingjue-xingzhe/data/field_bottle/raw/20261030T130154147817Z/00009.jpg

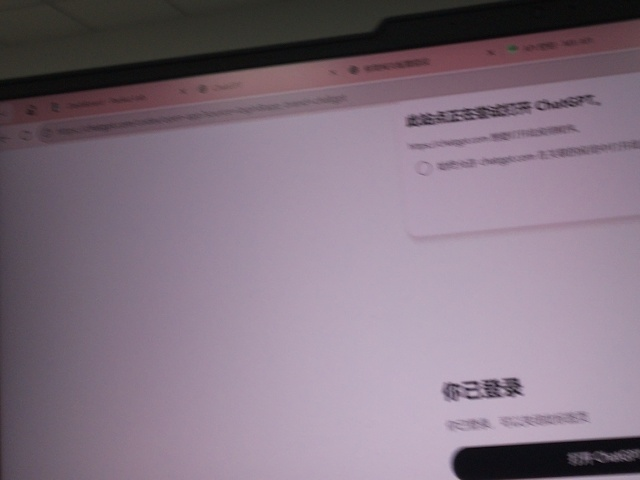
data/field_bottle/raw/20261030T130154147817Z/00009.jpg
