cxy-299/jingjue-xingzhe/docs/images/motor-driver.jpg

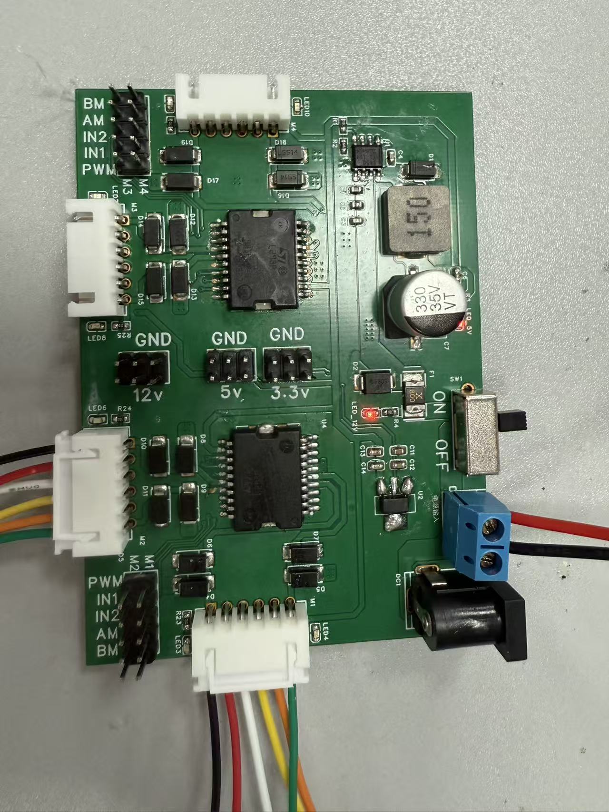
docs/images/motor-driver.jpg
