cxy-299/jingjue-xingzhe/docs/images/wechat-connect.png

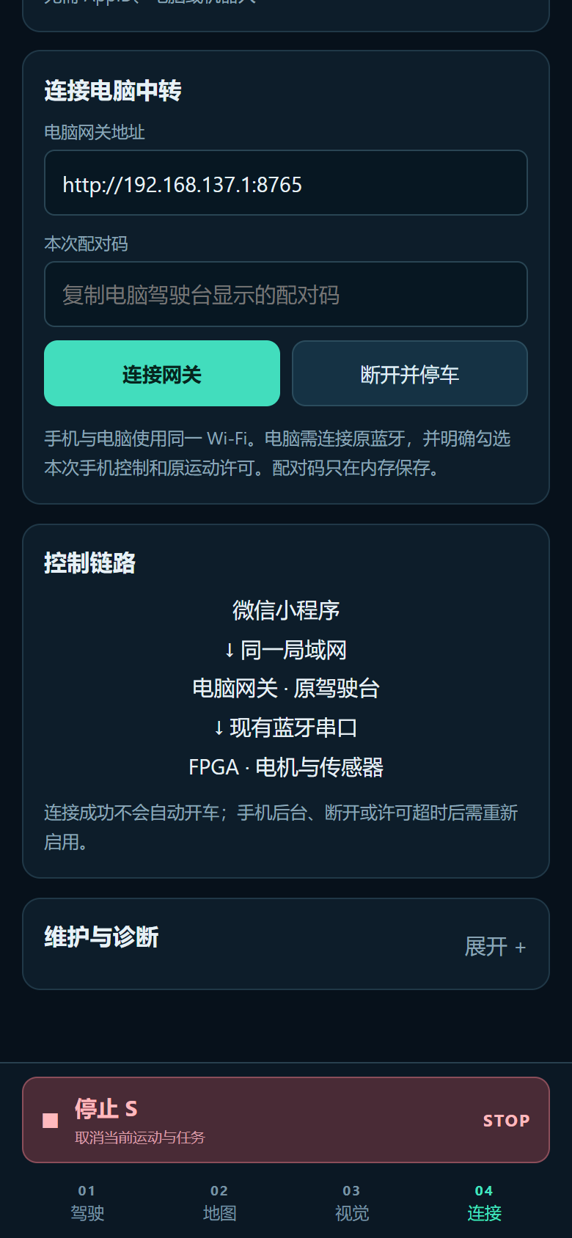
docs/images/wechat-connect.png
