cxy-299/jingjue-xingzhe/docs/images/wechat-drive.png

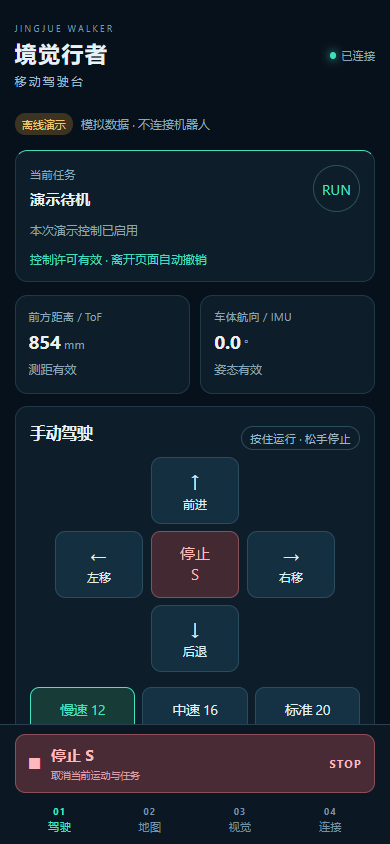
docs/images/wechat-drive.png
