cxy-299/jingjue-xingzhe/docs/images/wechat-map.png

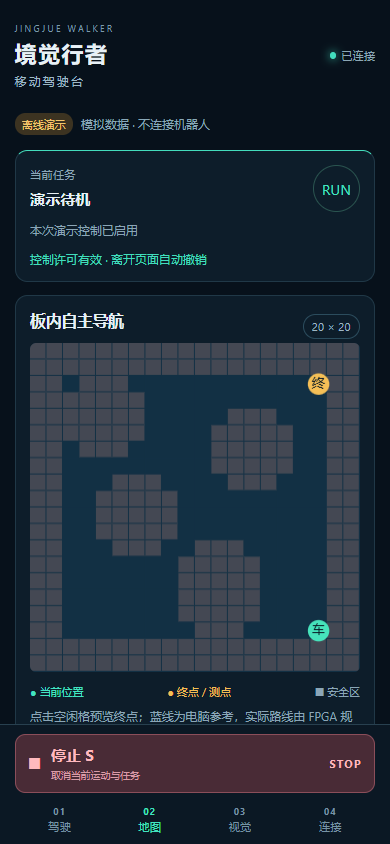
docs/images/wechat-map.png
