cxy-299/jingjue-xingzhe/docs/images/wechat-vision.png

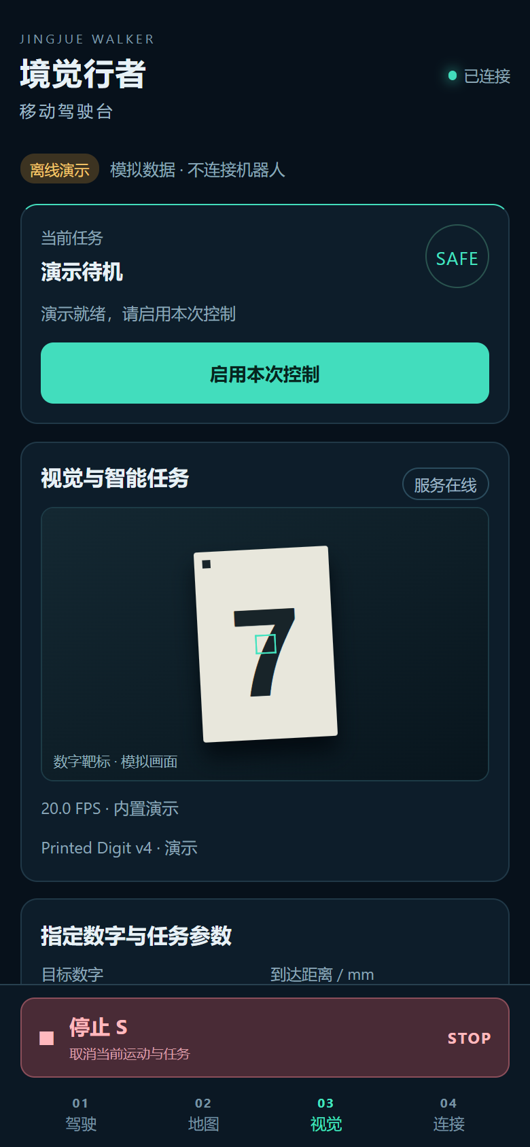
docs/images/wechat-vision.png
