cxy-299/jingjue-xingzhe/fpga/motor_m1_bringup/README.md

# ACG720 与新四路驱动板：M1 单轮试转

此工程是第一次接线验收专用的开环测试，不是四轮 PID 或导航位流。上板前须确认驱动板确实是 `E:\gowin\驱动板new\四路电机驱动_tps5450.epro2` 对应的版本；若实物改版，重新核对原理图和网表。所有接线均在 FPGA 与驱动板**断电**时完成。

另有独立的 `acg720_motor_m1_bringup_50.fs` 供 50% 占空比起动排查；原 `acg720_motor_m1_bringup.fs` 仍是 10%。50% 版本把单次试转限时缩为 500 ms，其他引脚及安全互锁不变。若曾在驱动板 H1 的 M1_IN1/M1_IN2 **实测**到 1/1，不要接上电机运行 50% 版本；先断电检查接线，并在拔下 M1 电机插头后测得按 S1 时确为约 3.3 V/0 V。

按用户选定的操作方式，新增独立的 `impl/pnr/acg720_motor_m1_toggle_50.fs`：S1 消抖后按一下启动 M1，再按一下停机，松开 S1 不会停；PWM 仍为 20 kHz、50%，方向仍是 IN1/IN2=1/0。S0 立即复位停机，单次运行满 10 秒会自动停机并点亮 LED5；这是未接编码器、尚未测定堵转电流时的联调安全上限，不是无限运行模式。再次按 S1 可重新启动计时。此位流只控制 M1，不能用于四轮或导航演示，也不证明电机实物一定会转。

若实测方向线为 IN1/IN2=1/0，且把驱动板 PWM/EN 端固定为高时电机可以正常转，而 20 kHz、50% 版不能转，可用独立诊断位流 `impl/pnr/acg720_motor_m1_toggle_dc.fs` 区分问题。它保留同一 S1 单击启停、S0 停机和上电互锁，但运行时让 M1_PWM 恒为高（100%），最长仅运行 1 秒；停机时 PWM、IN1 均为低，IN2 始终为低。它不改变 P7 接线，不用于长期运行。若此版也不转，应优先查实际 P7-1 到 H1 的线序、共地及位流版本；若此版转而 50% 版不转，再测 H1 端 PWM 的频率、高低电压、占空比和电机起动电流。驱动板 LED5/LED6 同时亮并不能单独判定 IN1/IN2 同高，也可能反映电机输出或 PWM 的瞬时状态，须以 H1 处对 GND 的逐针测量为准。

万用表直流档测到 50% PWM 约 1.67 V，符合 3.3 V 高电平与 0 V 低电平各占一半时的平均值，不能据此判断脉冲高电平不足。另做 `impl/pnr/acg720_motor_m1_kick_80.fs` 用于短时联调：S1 单击后先输出 100 ms 全占空比帮助起动，再以 20 kHz、80% PWM 维持；第二次按 S1 停止，S0 立即停止，单次最多 3 秒自动停机。它仅适用于架空车轮、只接 M1、可立即切断驱动板 12 V 的短时联调；尚未测得堵转电流前不要连续重复试验。先前 50% 版未转的测试缺少公共 GND，须在共地条件下重新测试，不能由该结果推断起动占空比不足。

**2026-10-19 实板更正：**操作者发现上一轮未将 FPGA 与驱动板共地；补齐公共 GND 后，上述 100 ms 起动＋80% PWM 位流已使 M1 正常转动。故此前“不转”和示波器毫伏级读数不能用来证明 50% PWM 起动转矩不足，也不能据此认定 FPGA 输出电压低或 RTL 错误。当前仅确认 M1 在此位流下可转；S1 二次按键停机、S0、3 秒超时、实际电流与其余三轮仍需分别实测。任何改线必须先关闭两板电源；公共 GND 不应在驱动板带电时插拔。

使用该切换版前，**若 H1 的 IN1/IN2=1/1 是万用表实测而不是猜测，先不要给驱动板 12 V 或接上电机**。两板均断电时先断开 P7 到 H1 的三根控制线，单独给 FPGA 供电并下载位流，在 P7 对 FPGA 自身 GND 测量：按 S1 前后，M1_IN1 约 0→3.3 V、M1_IN2 始终 0 V，M1_PWM 运行时为 20 kHz、50%。不要用 FPGA GPIO 向已断电的驱动板输入脚灌电。万用表只会显示 PWM 平均电压，不能代替示波器确认频率和波形。测量正常后先关闭 FPGA 电源，再恢复控制线和电机插头；车轮离地，先给 FPGA 供电并确认 LED2 闪烁、LED3 常亮、LED4 灭，再打开驱动板 12 V；点击 S1 启动，第二次点击 S1 停止。异常时按 S0 并立即关闭驱动板 12 V 电源。驱动板开关或断开 12 V 才是最终硬件断电手段。

整车照片中用户标记的车轮位置为：A=图右下、B=图左下、C=图左上、D=图右上。照片里的插座位置看起来分别对应 PCB 的 M1、M2、M3、M4，但仍须断电用导通档确认每束线实际到达哪个电机；字母是车轮标记，不是 FPGA 引脚名。首次只试 A/M1，其他三个电机插头暂时拔下。

## 已核对的接口

驱动板 EDA 网表中，H1 是 M1/M2 两列、五行的 2×5 控制接口：奇数脚为 M2，偶数脚为 M1。请先对照 PCB 的 **1 脚标记**和丝印确认方向；不要单凭照片猜排针哪端为 1 脚。H1 不含 GND。

另一排 H2 用于 M3/M4：1/2=M4/M3_PWM，3/4=M4/M3_IN1，5/6=M4/M3_IN2，7/8=AM4/AM3，9/10=BM4/BM3。H2 同样没有 GND。此信息先用于通道标记，当前 M1 专用位流不会驱动其余三路。

| FPGA 开发板 P7 物理脚 | FPGA 信号/球脚 | 驱动板连接 | 用途 |
| --- | --- | --- | --- |
| 1 | GPIO0_0 / A13 | H1-2 / M1_PWM | L298P 使能 PWM |
| 2 | GPIO0_1 / A14 | H1-4 / M1_IN1 | 方向输入 1 |
| 3 | GPIO0_2 / A15 | H1-6 / M1_IN2 | 方向输入 2 |
| 12 | GND | H3/H4/H5 任一明确标成 GND 的脚 | 信号共地 |

P7 是 2×20 排针，1、3 在同一侧，2、4 在另一侧；**P7-11 是 5 V，不是 GND**。驱动板 H3 为 5 V/GND，H4 为 3.3 V/GND，H5 为 12 V/GND，各排针电源与地交错。只接 GND，绝不能将电源脚接到 GPIO。FPGA 使用自身合规的独立电源，驱动板使用其自身 12 V 电源；不要从驱动板的 5 V、3.3 V 或 12 V 输出给 FPGA 供电。

ST 原厂 L298 数据手册给出的逻辑输入和使能高电平阈值最小 2.3 V，故在驱动板逻辑电源确实为 5 V、FPGA GPIO 电压确实为 3.3 V 且两板共地时，3.3 V 控制信号符合该芯片逻辑阈值。数据手册中的每通道直流输出电流 2 A 是**绝对最大额定值**，不是建议连续工作目标；整板散热、电机堵转电流尚须实测。资料：https://www.st.com/resource/en/datasheet/l298.pdf

驱动板 M1 六线插座网表：1=M1+、2=GND、3=BM1、4=AM1、5=5V、6=M1−。优先使用与该插座匹配且线序已核对的电机/编码器线束。AM1/BM1 为编码器原始信号，**此测试不接**；目前没有证明其高电平在 FPGA 的 3.3 V 容限以内。M2/M3/M4 电机插头先拔下，未用通道的 PWM/EN 不应悬空导致误转，可用 10 kΩ 电阻将未用通道的使能脚拉到 GND；切勿把 5 V 编码器输出直接连到 FPGA。

## 断电检查和首次试转

1. 两板及电池均断电。把车轮抬离地面，确认轮子不会碰到手、导线或桌面。只插 M1 的电机插头，其他电机插头拔下。
2. 对照 P7 与 H1 实际 1 脚标记逐根接上表四根线；特别核对共地线确实落在 GND，而不是相邻的 5 V/3.3 V/12 V。用万用表通断档检查相邻脚无短路。
3. **驱动板电源先保持关闭**。单独给 FPGA 供电并下载 `impl/pnr/acg720_motor_m1_bringup.fs`，操作选 `SRAM Program`。默认 PWM/IN1/IN2 均为低；LED2 心跳闪烁，LED3 就绪常亮，LED4/5 灭。不要使用旧 `acg720_nav_preview.fs`：那是 NAV3 LED 导航预览，未连接电机引脚。
4. 确认 P7 GPIO 所属 bank 为 3.3 V；必要时用万用表/示波器核对 P7-1/2/3 默认低电平，以及按住 S1 后 P7-1 约 20 kHz、10% PWM、P7-2 高、P7-3 低。此步驱动板仍不供电。
5. 驱动板输入正负极按 PCB/网表核对后才接 12 V 电源。优先用可限流台式电源；若使用电池，先核对电机堵转电流、L298P 额定电流和散热。上电后先测驱动板 12 V、5 V、3.3 V 电源是否正常，并确认电机不自转。
6. 短按 S1 试转，首次不超过 1 秒，观察电流、电机方向、板温和噪声；松手应立即停。每次按下最长 2 秒，超时后要松开再按。若 10% 占空比不足以克服摩擦，不要贸然提高占空比；先确认电源、接线和电机参数。
7. 异常时立刻松开 S1 或关闭驱动板电源。S0 是 FPGA 逻辑复位，也会立即停输出，但不能代替切断电机 12 V 电源。修改接线前必须两板断电。

断电顺序为**先关闭驱动板的 12 V 电源，再关闭 FPGA 电源**。不要在驱动板仍有电时拔掉 FPGA 或公共地线；输出脚在配置、断电或拔线期间不能当作可靠的硬件急停。

## 位流行为与验证范围

- 控制方向固定为 M1_IN1=1、M1_IN2=0（仅试转时），M1_PWM 为 20 kHz、10%。真实正反方向由电机接线定义；不要在带电状态交换线。
- FPGA 配置完成后等待 20 ms，S1 必须在此后至少松开一次，才允许重新按下；S1 按下消抖 10 ms。S1 原始松开电平及 S0 复位直接门控输出。
- LED2：心跳；LED3：上电等待结束；LED4：电机使能；LED5：单次按住超时。LED0/1、LED6/7 未由本位流驱动，不用它们判断本测试结果。
- ModelSim 测试台缩短时基，覆盖默认停车、上电按住互锁、按键消抖、PWM 占空、松手立即停止、按住超时、S0 复位；只证明 RTL 仿真，不证明实板电压/电流/线序正确。
- 当前不接编码器，因此无速度反馈、无 PID。四轮闭环须先核验编码器电平、每转脉冲数、轮径、方向，再整合到主工程。

## 复现命令

在此目录运行 ModelSim：`& 'D:\software\modelism\win64\vsim.exe' -c -do run_modelsim.do`。

50% 版本仿真：`& 'D:\software\modelism\win64\vsim.exe' -c -do run_modelsim_50.do`。

运行 Gowin 构建：`& 'D:\software\gowin\Gowin_V1.9.12.04_x64\IDE\bin\gw_sh.exe' build.tcl`。

50% 版本构建：`& 'D:\software\gowin\Gowin_V1.9.12.04_x64\IDE\bin\gw_sh.exe' build_50.tcl`。

S1 单击切换版仿真：`& 'D:\software\modelism\win64\vsim.exe' -c -do run_modelsim_toggle_50.do`。

S1 单击切换版构建：`& 'D:\software\gowin\Gowin_V1.9.12.04_x64\IDE\bin\gw_sh.exe' build_toggle_50.tcl`。

PWM 恒高诊断版仿真：`& 'D:\software\modelism\win64\vsim.exe' -c -do run_modelsim_toggle_dc.do`。

PWM 恒高诊断版构建：`& 'D:\software\gowin\Gowin_V1.9.12.04_x64\IDE\bin\gw_sh.exe' build_toggle_dc.tcl`。

100 ms 起动、80% PWM 单轮版仿真：`& 'D:\software\modelism\win64\vsim.exe' -c -do run_modelsim_kick_80.do`。

100 ms 起动、80% PWM 单轮版构建：`& 'D:\software\gowin\Gowin_V1.9.12.04_x64\IDE\bin\gw_sh.exe' build_kick_80.tcl`。

本工程不自动下载位流，也不会重启电脑或树莓派。
