cxy-299/jingjue-xingzhe/apps/wechat_console/docs/VALIDATION.md

# 软件验证记录与实机使用状态

验证日期：2026-11-02。只使用离线演示、注入时钟、回环 HTTP、假串口和隐藏 Tk 窗口；没有触碰现场蓝牙、树莓派或 FPGA。

## 已执行

网关与视觉代理11项测试全部通过。覆盖未授权禁动、400ms手机租约、失效后心跳不能重新授权、旧会话/序号重放、指令截止时间、手机松手后旧按压失效、电脑许可撤销、HTTP配对码/请求类型/大小限制、Tk主线程分发、过期排队请求不执行，以及具体检测ID传入原Pi API。日志和XML在 `qa/gateway_final.*`。

小程序 JS 客户端6项测试全部通过。覆盖地图可达性、离线导航、地址/配对码限制、按压释放、后台/返回、延迟的启用响应不能恢复许可、排队过期、原生事件与生命周期绑定和项目JSON。日志在 `qa/client.log`。

原驾驶台及新适配器共45个不同用例完成通过：首轮43通过、2失败，保留 `qa/pc_regression.xml/log`。两失败分别为Tk初始化读取init.tcl异常，以及同进程批量Tk运行中的旧K回传时效用例。随后两项均在独立新进程、相同生产源码上通过，见 `qa/pc_recheck_applied.*` 与 `qa/pc_recheck_stale_k.*`。没有为重试修改既有用例或放宽判据。

这45项包括新手机适配实际隐藏Tk/原AsyncTrackedPort/假串口路径，以及旧R20避障确认、任务5数字触发ToF、失联/取消、地图测点与断开清除等回归。新适配器测试验证手机不能替代本地运动许可、本地停止S能撤销手机许可，所有端口为测试替身。

同一WXML/WXSS通过DOM适配器在390px与320px宽度完成四标签布局检查，无横向溢出和页面脚本异常；模拟启用、松手停止、地图路线和后台不恢复验证通过。截图 `qa/*-phone.png`；实际范围在 `qa/visual_result.json`。适配器首轮发现的条件绑定已修复后重新检查。首轮JS测试曾使用错误的测试断言字段，修正测试取值后6项通过；无实际控制接口绕过。

## 实机使用状态与历史测试范围

2026年11月3日，项目作者确认小程序已完成实物机器人连接与控制验证，手机—电脑网关—蓝牙—FPGA链路实际可用。前述2026年11月2日记录是当时自动化测试的原始范围，使用模拟后端、假串口与隐藏Tk；这些软件测试与后续实机验证分别记录，不用模拟测试替代现场结果，也不虚构未提供的延迟、成功率或平台发布数据。

没有改RTL、时钟/STA约束、板端参数或固件。现有固件与此前独立归档保持原状。原驾驶台的普通启动入口默认不加载网关，仅新启动器显式传入remote_factory才启用。之前代码RAR保持未覆盖，本扩展单独交付。
