cxy-299/jingjue-xingzhe/apps/wechat_console/qa/connect-phone.png

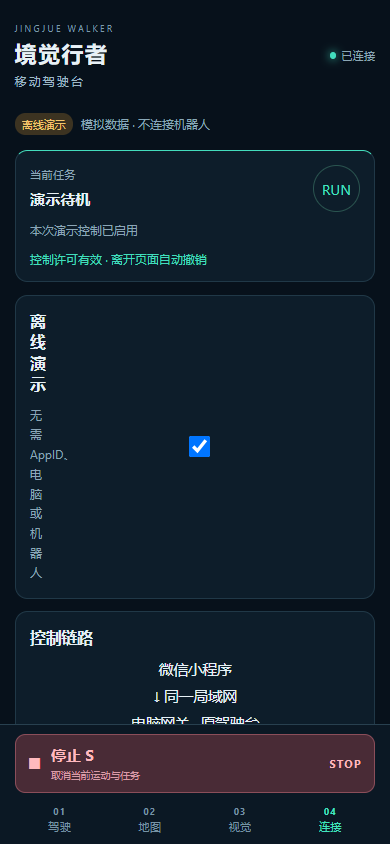
apps/wechat_console/qa/connect-phone.png
