cxy-299/jingjue-xingzhe/apps/wechat_console/qa/drive.png

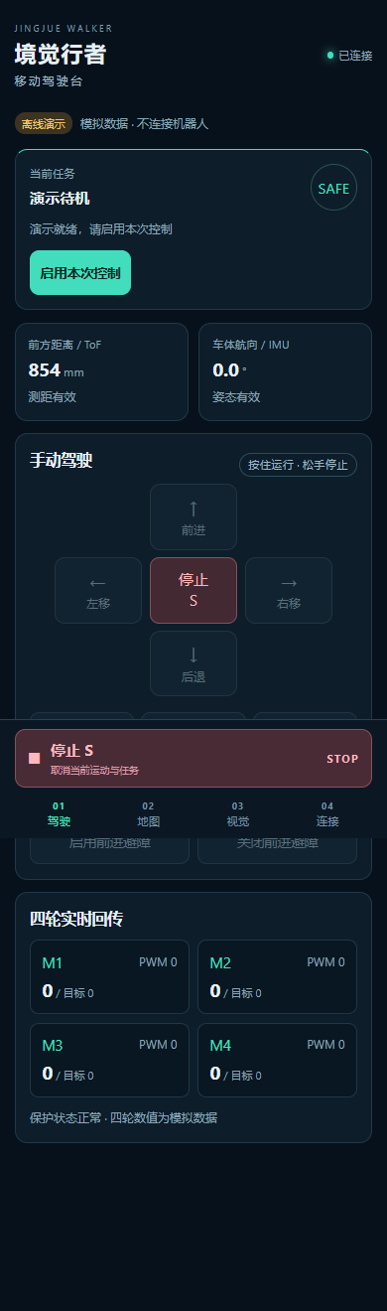
apps/wechat_console/qa/drive.png
