cxy-299/jingjue-xingzhe/apps/wechat_console/qa/vision-phone.png

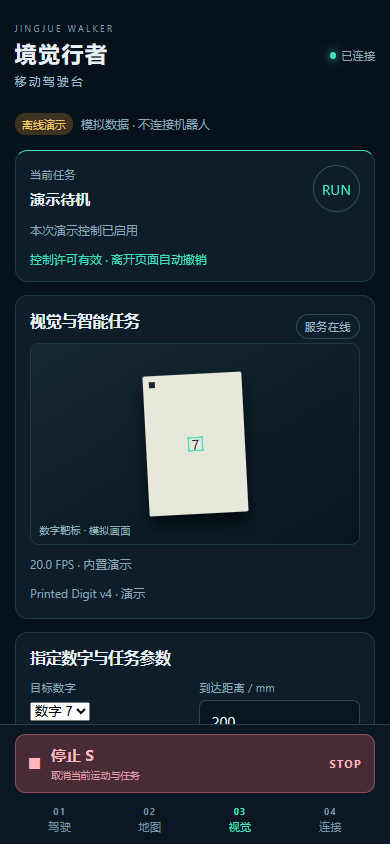
apps/wechat_console/qa/vision-phone.png
