cxy-299/jingjue-xingzhe/tests/fixtures/a4_whitewall_20261031/raw_zero.jpg

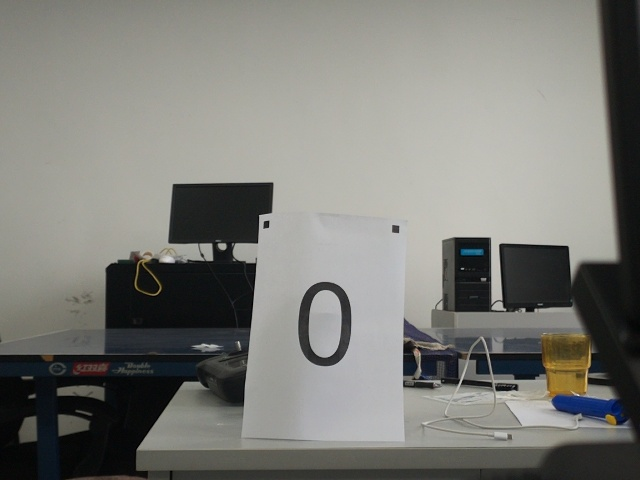
tests/fixtures/a4_whitewall_20261031/raw_zero.jpg
