cxy-299/jingjue-xingzhe/tests/fixtures/a4_whitewall_20261031/raw_zero_500mm.jpg

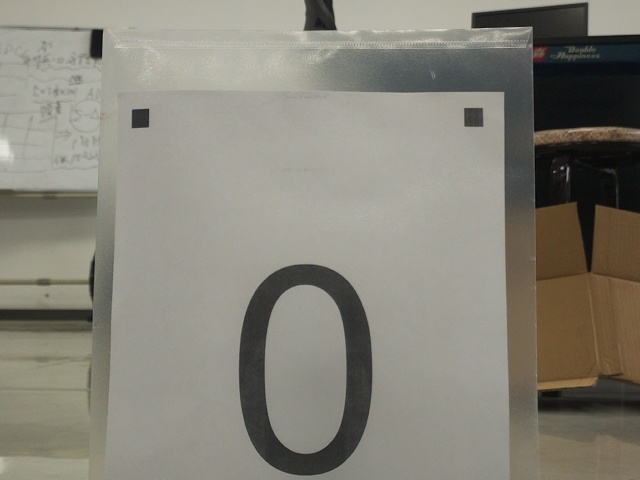
tests/fixtures/a4_whitewall_20261031/raw_zero_500mm.jpg
