cxy-299/jingjue-xingzhe/tests/fixtures/a4_whitewall_20261031/raw_zero_background_20261101.jpg

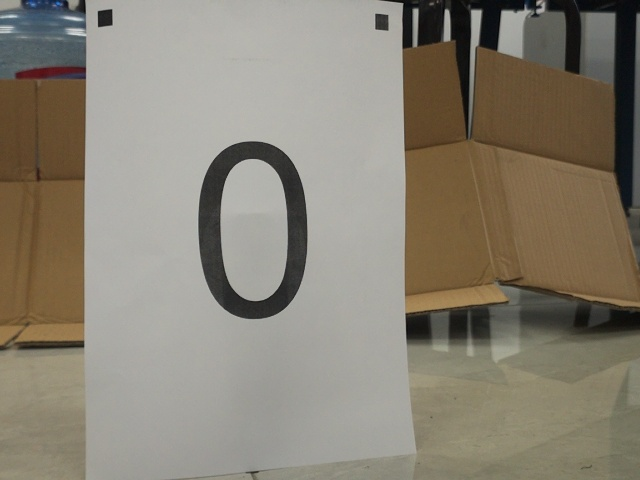
tests/fixtures/a4_whitewall_20261031/raw_zero_background_20261101.jpg
