cxy-299/jingjue-xingzhe/tests/fixtures/a4_whitewall_20261031/user_near_zero.png

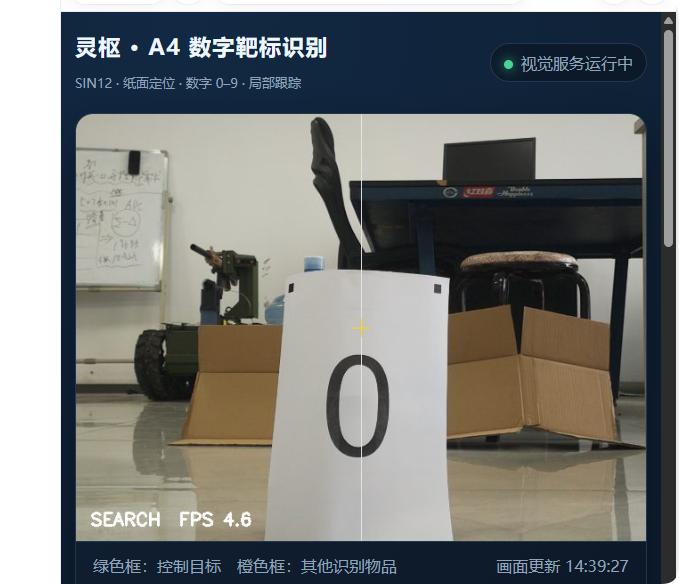
tests/fixtures/a4_whitewall_20261031/user_near_zero.png
